Shep-pard/ICHausInterpolation/Doc/Doku.pdf

# ICHaus Interpolationsplatine

## Kurzanleitung

## Sören Alrutz

## Platine zum Wandeln von 1Vpp und 11µAss Signalen zu 5V TLL Level

## 25. Juni 2020

ICHaus Interpolationsplatine Anleitung | 25. Juni 2020

## 1 Disclaimer

Die Anleitung wurde nach bestem Wissen und Gewissen geschrieben, allerdings nicht sonderlich Intensiv auf sprachliche/Inhaltliche Fehler gepruft. Die Platine wurde fast ¨ vollständig nach Schaltplänen und Vorschlägen des Datenblatts aufgebaut. Hier sind alle Information auch noch genauer erklärt. Schaltpläne und Layout sind auf meinen Github zu finden: https://github.com/Shep-pard/ICHausInterpolation

## 2 Basics zum Verwendeten IC

Die Platine basiert auf dem ICHaus IC-NV IC. Dies ist ein vollintegrierter 6 Bit Sin/Cos Interpolationschip. Durch die 6 Bit ist eine Auflösung von 64 Pulsen pro Periode möglich. Dies entspricht einer 16-fachen Interpolation des sinusförmigen Signals.
Die Eingangssignale durfen bei maximaler Interpolation noch eine Frequenz von 200kHz ¨ haben. Bei niedrigeren Faktoren ist eine maximale Frequenz bis zu 320kHz möglich. Das Referenzsignal des Eingangs kann uber einen Komparator ausgegeben werden. ¨

## 3 Aufbau der Platine

Abbildung 1 zeigt eine der Platinen von der Seite. An der unteren Seite sind die Steckverbinder. Es können jeweils sowohl 9 Pin D-Sub Buchsen als auch 2Pin 3,5mm Pitch Steckverbinder verwendet werden. Der linke Stecker ist der Eingang fur Encoder/GMS. ¨ Der rechte Stecker geht an die Auswertung und versorgt die Platine mit 5V. Seitlich neben dem GMS Eingang ist noch ein weiterer 2 Pin Steckverbinder. Dieser ist zum Anschluss des Schirms des GMS gedacht wenn kein D-Sub Verbinder verwendet wird.

Seite 2


Abbildung 1: Gesamtansicht der Platine

Des weiteren ist auf der Platine auf der linken Seite ein Operationsverstärker zur Interpretation des Referenzimpuls verbaut. In der Mitte ist der IC-NV und rechts davon ein 4 Kanal Differentialtreiber um die Signale des IC-NV Störungssicher auszugeben.

## 4 Steckverbinder Pinout

D-Sub

Das Pinout der D-Sub Verbinder ist fur beide fast identisch. Auf Tabelle 1 sind beide ¨ Pinouts aufgelistet. Der Unterschied ist nur der dedizierte Schirm Anschluss fur den ¨ Encoder/GMS.

3,5mm Schraubklemmen

Zur Verdrahtung der Schraubklemmen ist jeder Pin auf der Platine einzeln beschriftet. Nur fur den Schirm des Encoder/GMS Anschluss ist eine extra Schraubklemme vorhan- ¨ den.
Fehler bei der Beschriftung: Bei P5 steht neben SSchirmfälschlicherweise 5V und GND. Das kann ignoriert werden!

## 5 Platine Einstellen

Die Platine ist standardmäßig fur die Verwendung mit 11 ¨ | µAss ausgelegt.

Seite 3

Tabelle 1: Pinout D-Sub 9 Verbinder
Pin | TTL Output | Encoder/GMS Eingang
1 | GND | Schirm
2 | Z- | Z-
3 | B- | B-
4 | A- | A-
5 | 5V In | 5V Out
6 | GND | GND
7 | Z+ | Z+
8 | B+ | B+
9 | A+ | A+

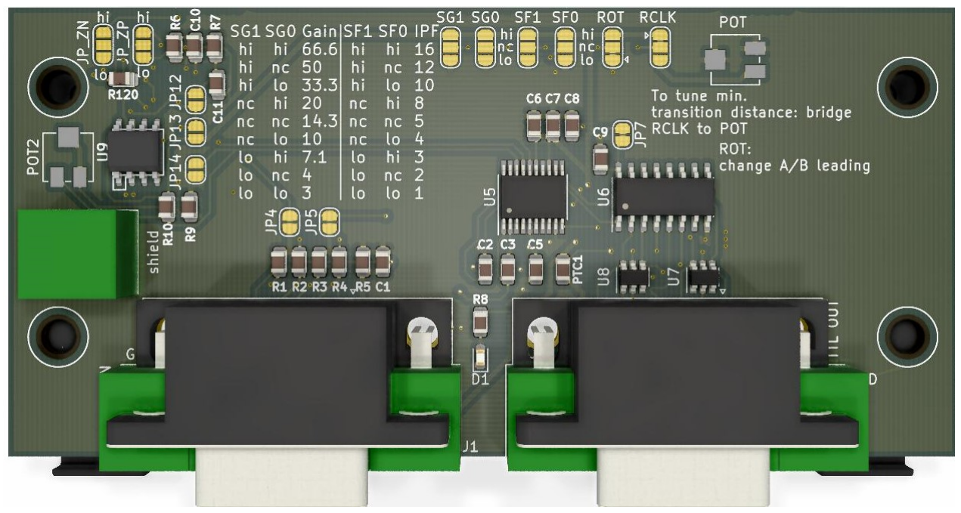
[picture p5: figure]

Abbildung 2: Top Ansicht der Platine

11µAss

Zur Auswertung von 11µAss Signalen mussen auf der Platine einige Grundvorausset- ¨ zungen erfullt sein: ¨

| R1-R4 mussen 25kΩ sein ¨
| JP2/JP3 offen
| JP4/JP5 geschlossen

Um den Referenzimpuls auszuwerten muss zusätzlich JP12 geschlossen sowie JP ZN und JP VP auf lo sein.
Der Gain kann auf zwischen 4 oder 7,1 mit den Jumpern SG0 und SG1 gestellt werden. Wenn das Ergebnis nicht zufriedenstellend ist, muss der Gain eventuell experimentell angepasst werden.

Seite 4

1VPP

| R2 und R4 mussen 120Ω sein ¨
| JP2/JP3 geschlossen
| JP4/JP5 geschlossen

Um den Referenzimpuls auszuwerten muss zusätzlich JP12-JP15 offen sowie JP ZN und JP VP auf high sein.
Der Gain kann auf zwischen 3 oder 4 mit den Jumpern SG0 und SG1 gestellt werden. Wenn das Ergebnis nicht zufriedenstellend ist, muss der Gain eventuell experimentell angepasst werden.

Referenzsignal

Das Referenzsignal des Encoder/GMS kann entweder ausgewertet werden oder es kann automatisch ein Impuls jede Periode erzeugt werden. Fur die automatische Signalerzeu- ¨ gung JP13/JP14 schließen.

Fur die Auswertung muss das Poti POT2 korrekt eingestellt werden. Zur Erkl ¨ | ärung sind
auf Abbildung 3 die analogen Signale eines 11µAss GMS abgebildet. Das Referenzsignal ist die rote Kurve unten. Das Poti verändert das blaue Signal. Zur Auswertung des Referenzimpuls ist sowohl das blaue als auch das rote Signal an einen Komperator angeschlossen. Wenn die rote Kurve uber der blauen ist, wird in der Sinusperiode ein ¨ Referenzimpuls ausgegeben.

Seite 5


Abbildung 3: Analoge Signale von einem GMS

Um das Poti einzustellen, können die Spannungen entweder mit einem Oszilloskop gemessen und angepasst werden oder mit Hilfe von LinuxCNC ausgewertet werden. Zur Auswertung in LinuxCNC das Halscope öffnen und Encoder A/B/Index Signale anzeigen und auf das Index Signal triggern. Immer uber den Referenzimpuls fahren und das Poti ¨ einstellen bis nur noch ein Referenzimpuls angezeigt wird. Siehe Abbildung 4

Seite 6


Abbildung 4: Auswertung des Encoders/GMS in Linuxcnc

Ausgangssignale

Der Output der TTL Signale kann normal oder differentiell ubertragen werden. Stan- ¨ dardmäßig wird ein differentielles Signal ausgegeben. Wenn dies nicht gewunscht ist, ¨ muss mit einem Messer JP7 aufgetrennt werden und JP8-JP10 geschlossen werden.

Seite 7
