Shep-pard/ICHausInterpolation/Doc/bot.jpg

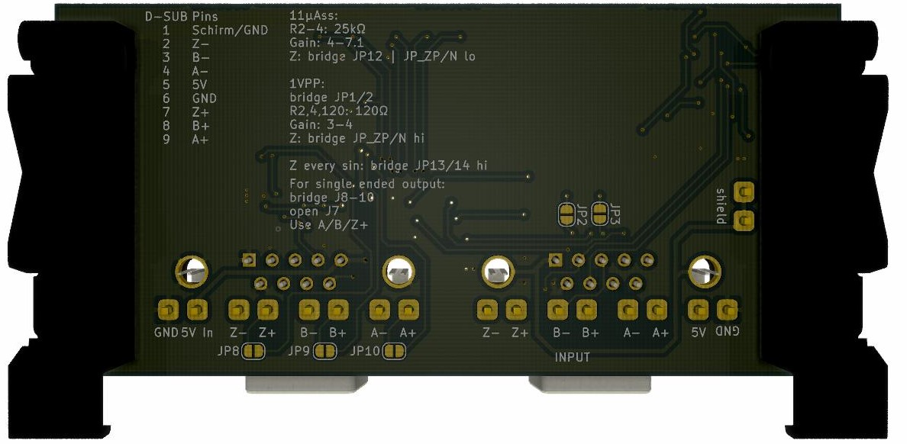
Doc/bot.jpg
