Shep-pard/ICHausInterpolation/ICHaus/doc/ICHaus_BOM_V2.xlsx

Designator | Quantity | Value | Footprint | LCSC Part #
C3,C2,C10,C11, C103,C102,C110,C111 | 4 | 220p | stmbl:C_0805 | C53172
C6,C7,C9,C1,C5,C8,C106,C107,C109,C101,C105,C108 | 6 | 100n | stmbl:C_0805 | C49678
D1,D101 | 1 | LED | LED_SMD:LED_0603_1608Metric | C72043
PTC1,PTC2 | 1 | JK-SMD0805-035 | stmbl:C_0805 | C369149
R10,R110 | 1 | 24k | stmbl:C_0805 | C17575
R7,R6,R107,R106 | 2 | 100k | stmbl:C_0805 | C17407
R8,R5,R108,R105 | 1 | 220 | stmbl:C_0805 | C17557
R9,R109 | 1 | 0 | stmbl:C_0805 | C17477
U5 | 1 | IC-NV | Package_SO:TSSOP-20_4,4x6,5mm_P0,65mm
U6,U106 | 1 | am26ls31 | Package_SO:SOIC-16_3,9x9,9mm_P1,27mm | C6179
U7,U8,U107,U108 | 2 | SRV05-4 | Package_TO_SOT_SMD:SOT-23-6 | C85364
U9,U109 | 1 | MCP6001U | stmbl:SOIC-8-N | C7377
