Shep-pard/ICHausInterpolation/ICHaus/ICHaus.sch

## KiCad design ICHaus/ICHaus.sch (2020-05-30)

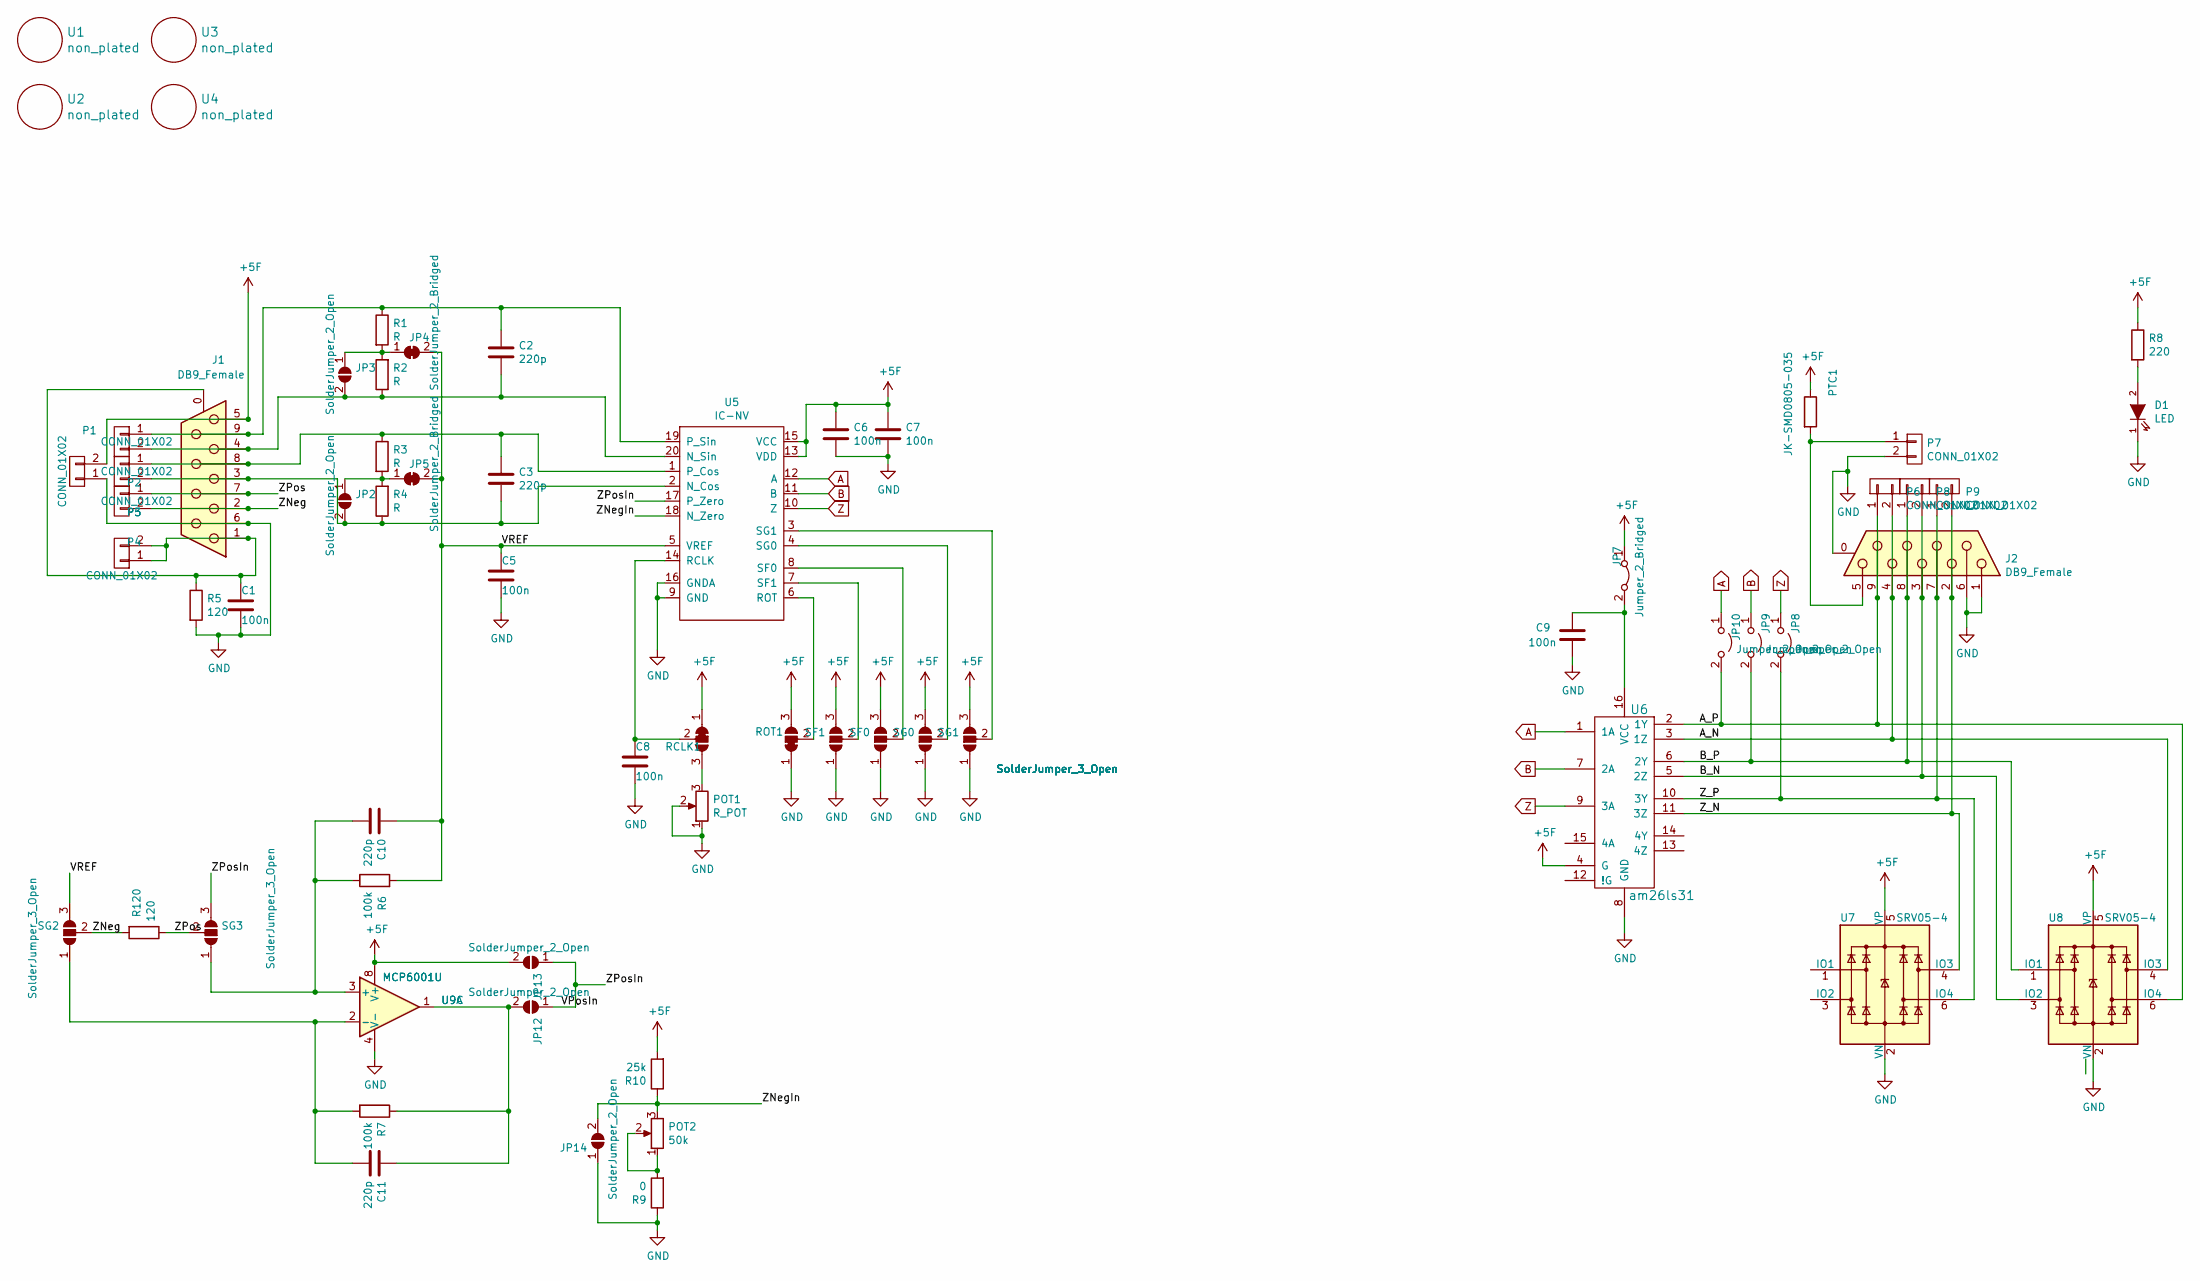
[picture p7: schematic ICHaus.sch]

Parts:
C1, C5, C6, C7, C8, C9: 100n; C_0805
C2, C3, C10, C11: 220p; C_0805
D1: LED; LED_0603_1608Metric
J1, J2: DB9_Female; DSUB-9_Female_Horizontal_P2.77x2.84mm_EdgePinOffset7.70mm_H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
JP2, JP3, JP12, JP13, JP14: SolderJumper_2_Open; SolderJumper-2_P1.3mm_Open_RoundedPad1.0x1.5mm
JP4, JP5: SolderJumper_2_Bridged; SolderJumper-2_P1.3mm_Bridged_RoundedPad1.0x1.5mm
JP7: Jumper_2_Bridged; SolderJumper-2_P1.3mm_Bridged_RoundedPad1.0x1.5mm
JP8, JP9, JP10: Jumper_2_Open; SolderJumper-2_P1.3mm_Open_RoundedPad1.0x1.5mm
P1, P2, P3, P4, P5, P6, P7, P8, P9: CONN_01X02; RM3.5_1x2
POT1: R_POT; Potentiometer_Bourns_3214J_Horizontal
POT2: 50k; Potentiometer_Bourns_3214J_Horizontal
PTC1: JK-SMD0805-035; C_0805
R1, R2, R3, R4: R; C_0805
R5, R120: 120; C_0805
R6, R7: 100k; C_0805
R8: 220; C_0805
R9: 0; C_0805
R10: 25k; C_0805
RCLK1: SolderJumper_3_Open; SolderJumper-3_P1.3mm_Bridged12_RoundedPad1.0x1.5mm
ROT1: SolderJumper_3_Open; SolderJumper-3_P1.3mm_Bridged12_RoundedPad1.0x1.5mm
SF0, SF1: SolderJumper_3_Open; SolderJumper-3_P1.3mm_Open_RoundedPad1.0x1.5mm_NumberLabels
SG0, SG1, SG2, SG3: SolderJumper_3_Open; SolderJumper-3_P1.3mm_Open_RoundedPad1.0x1.5mm_NumberLabels
U1, U2, U3, U4: non_plated; non_plated_3mm
U5: IC-NV; TSSOP-20_4.4x6.5mm_P0.65mm
U6: am26ls31; SOIC-16_3.9x9.9mm_P1.27mm
U7, U8: SRV05-4; SOT-23-6
U9: MCP6001U; SOIC-8-N

Connections:
+5F: C6.1, C7.1, J1.5, JP7.1 (A), JP13.2 (B), P1.2, PTC1.1, R8.1, R10.2, RCLK1.1 (A), ROT1.3 (B), SF0.3 (B), SF1.3 (B), SG0.3 (B), SG1.3 (B), U5.13 (VDD), U5.15 (VCC), U6.4 (G), U7.5 (VP), U8.5 (VP), U9.8 (V+)
A: JP10.1 (A), U5.12 (A), U6.1 (1A)
A_N: J2.4, P6.2, U6.3 (1Z), U8.4 (IO3)
A_P: J2.9, JP10.2 (B), P6.1, U6.2 (1Y), U8.6 (IO4)
B: JP9.1 (A), U5.11 (B), U6.7 (2A)
B_N: J2.3, P8.2, U6.5 (2Z), U8.3 (IO2)
B_P: J2.8, JP9.2 (B), P8.1, U6.6 (2Y), U8.1 (IO1)
GND: C1.2, C5.2, C6.2, C7.2, C8.2, C9.2, D1.1 (K), J1.6, J2.0 (PAD), J2.1, J2.6, JP14.1 (A), P1.1, P7.2, POT1.1, POT1.2, R5.2, R9.1, ROT1.1 (A), SF0.1 (A), SF1.1 (A), SG0.1 (A), SG1.1 (A), U5.9 (GND), U5.16 (GNDA), U6.8 (GND), U7.2 (VN), U8.2 (VN), U9.4 (V-)
unnamed: C1.1, J1.0 (PAD), J1.1, P5.1, P5.2, R5.1
unnamed: C2.1, J1.9, P2.1, R1.1, U5.19 (P_Sin)
unnamed: C2.2, J1.4, JP3.2 (B), P2.2, R2.1, U5.20 (N_Sin)
unnamed: C3.1, J1.8, P3.1, R3.1, U5.1 (P_Cos)
unnamed: C3.2, J1.3, JP2.2 (B), P3.2, R4.1, U5.2 (N_Cos)
unnamed: C8.1, RCLK1.2 (C), U5.14 (RCLK)
unnamed: C9.1, JP7.2 (B), U6.16 (VCC)
unnamed: C10.2, R6.1, SG3.1 (A), U9.3 (+)
unnamed: C11.1, JP12.2 (B), R7.1, U9.1
unnamed: C11.2, R7.2, SG2.1 (A), U9.2 (-)
unnamed: D1.2 (A), R8.2
unnamed: J2.5, P7.1, PTC1.2
unnamed: JP2.1 (A), JP5.1 (A), R3.2, R4.2
unnamed: JP3.1 (A), JP4.1 (A), R1.2, R2.2
unnamed: POT1.3, RCLK1.3 (B)
unnamed: POT2.1, POT2.2, R9.2
unnamed: ROT1.2 (C), U5.6 (ROT)
unnamed: SF0.2 (C), U5.8 (SF0)
unnamed: SF1.2 (C), U5.7 (SF1)
unnamed: SG0.2 (C), U5.4 (SG0)
unnamed: SG1.2 (C), U5.3 (SG1)
VPosIn: JP12.1 (A), JP13.1 (A), SG3.3 (B), U5.17 (P_Zero)
VREF: C5.1, C10.1, JP4.2 (B), JP5.2 (B), R6.2, SG2.3 (B), U5.5 (VREF)
Z: JP8.1 (A), U5.10 (Z), U6.9 (3A)
ZNeg: J1.2, P4.2, R120.2, SG2.2 (C)
ZNegIn: JP14.2 (B), POT2.3, R10.1, U5.18 (N_Zero)
ZPos: J1.7, P4.1, R120.1, SG3.2 (C)
Z_N: J2.2, P9.2, U6.11 (3Z), U7.4 (IO3)
Z_P: J2.7, JP8.2 (B), P9.1, U6.10 (3Y), U7.6 (IO4)
