Shep-pard/ICHausInterpolation/(commit log)

2020-04-27 layout prefinal
    [ICHaus-B_Cu.gbl, ICHaus-B_Mask.gbs, ICHaus-B_Paste.gbp, ICHaus-B_SilkS.gbo, ICHaus-Edge_Cuts.gm1, ICHaus-F_Cu.gtl, ICHaus-F_Mask.gts, ICHaus-F_Paste.gtp]
2020-04-29 dual pcb
    [ICHaus-B_Cu.gbl, ICHaus-B_Mask.gbs, ICHaus-B_Paste.gbp, ICHaus-B_SilkS.gbo, ICHaus-Edge_Cuts.gm1, ICHaus-F_Cu.gtl, ICHaus-F_Mask.gts, ICHaus-F_Paste.gtp]
2020-05-09 probably final version
    [ICHaus-B_Cu.gbl, ICHaus-B_Mask.gbs, ICHaus-B_Paste.gbp, ICHaus-B_SilkS.gbo, ICHaus-Edge_Cuts.gm1, ICHaus-F_Cu.gtl, ICHaus-F_Mask.gts, ICHaus-F_Paste.gtp]
2020-05-17 z-detection
    added opamp for z impuls detection. (11uass)
    [ICHaus-B_Cu.gbl, ICHaus-B_Mask.gbs, ICHaus-B_Paste.gbp, ICHaus-B_SilkS.gbo, ICHaus-Edge_Cuts.gm1, ICHaus-F_Cu.gtl, ICHaus-F_Mask.gts, ICHaus-F_Paste.gtp]
2020-05-30 production files
    [ICHaus.kicad_pcb, ICHaus.sch, ICHaus_BOM_V2.xlsx]
2021-08-04 removed unused files
    [ICHaus_BOM.xlsx, Pos_STK.xlsx, Pos_STK2.xlsx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]
